Dashjax/RobocupSwinder/README.md

# RobocupSwinder
Robocup intro project with the goal to create a solenoid coil winder. :)
