Dashjax/RobocupSwinder/KiCad/BoardDeco/RoboBuzz wireframe.png

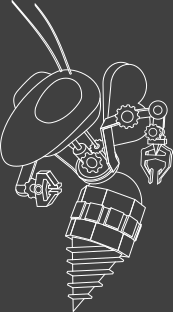
KiCad/BoardDeco/RoboBuzz wireframe.png
