Dashjax/RobocupSwinder/KiCad/final_report_bom.xlsx

Item | Links | Quantity | Price | Total
0.22uF Capacitor | https://www.digikey.com/en/products/detail/walsin-technology-corporation/1206B224K500CT/15980737 | 2 | 0.12 | 0.24
0.1uF Capacitor | https://www.digikey.com/en/products/detail/walsin-technology-corporation/1206B104K500CT/9355102 | 2 | 0.13 | 0.26
Barrel Jack | https://www.digikey.com/en/products/detail/same-sky-formerly-cui-devices/PJ-037A/1644545 | 2 | 0.6 | 1.2
10k Resistor | https://www.digikey.com/en/products/detail/yageo/RC1206FR-0710KL/728483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 | 4 | 0.1 | 0.4
1k Resistor | https://www.digikey.com/en/products/detail/yageo/RC1206FR-071KL/728387 | 4 | 0.1 | 0.4
2 Pin XH Connector Male | https://www.digikey.com/en/products/detail/jst-sales-america-inc/XHP-2/555485 | 2 | 0.1 | 0.2
2 Pin XH Connector Female | https://www.digikey.com/en/products/detail/jst-sales-america-inc/B2B-XH-A/1651045 | 2 | 0.1 | 0.2
8 Pin Header | https://www.digikey.com/en/products/detail/sullins-connector-solutions/PPTC081LFBN-RC/810147 | 8 | 0.56 | 4.48
24 Pin Header | https://www.digikey.com/en/products/detail/sullins-connector-solutions/PPTC241LFBN-RC/810162 | 4 | 1.3 | 5.2
Linear Regulator | https://www.digikey.com/en/products/detail/texas-instruments/LM340MPX-5-0-NOPB/367021 | 2 | 1.38 | 2.76
Limit Switches | https://www.amazon.com/HiLetgo-KW12-3-Roller-Switch-Normally/dp/B07X142VGC | 1 | 5.99 | 5.99
Power Switch | https://www.digikey.com/en/products/detail/e-switch/RA1113112R/3778055 | 2 | 0.71 | 1.42
I2C Adapter | https://www.amazon.com/HiLetgo-Interface-LCD1602-Address-Changeable/dp/B00VC2NEU8?gQT=0 | 1 | 7.49 | 7.49
LCD Screen | https://www.amazon.com/HiLetgo-Display-Backlight-Controller-Character/dp/B00HJ6AFW6 | 1 | 8.99 | 8.99
Screws | https://www.amazon.com/dp/B0B373RNJP/ref=twister_B0B373D6M8?_encoding=UTF8&th=1 | 1 | 4.5 | 4.5
Inserts | https://www.amazon.com/Mardatt-M2x4x3-5-Threaded-Printing-Embedment/dp/B08ZH89PK4 | 1 | 3.49 | 3.49
 |  |  |  | 47.22
