Dashjax/RobocupSwinder/KiCad/3dmodels/Same_Sky_PJ-037A.step

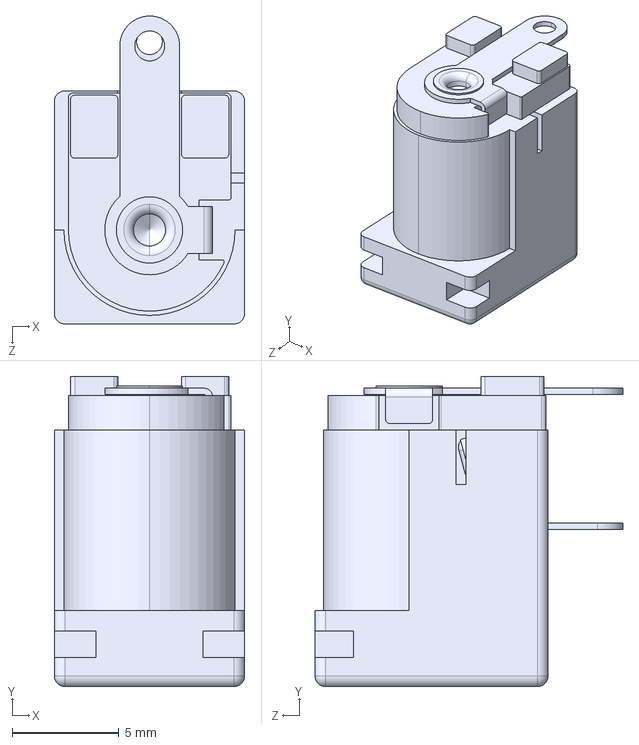
[picture p2: CAD file, 2025-03-05]
KiCad/3dmodels/Same_Sky_PJ-037A.step
8.90 x 14.5 x 14.4 mm
