Dashjax/RobocupSwinder/KiCad/RobocupSwinderPCB/RobocupSwinderPCB.kicad_pcb

## KiCad design KiCad/RobocupSwinderPCB/RobocupSwinderPCB.kicad_pcb (2025-10-14)

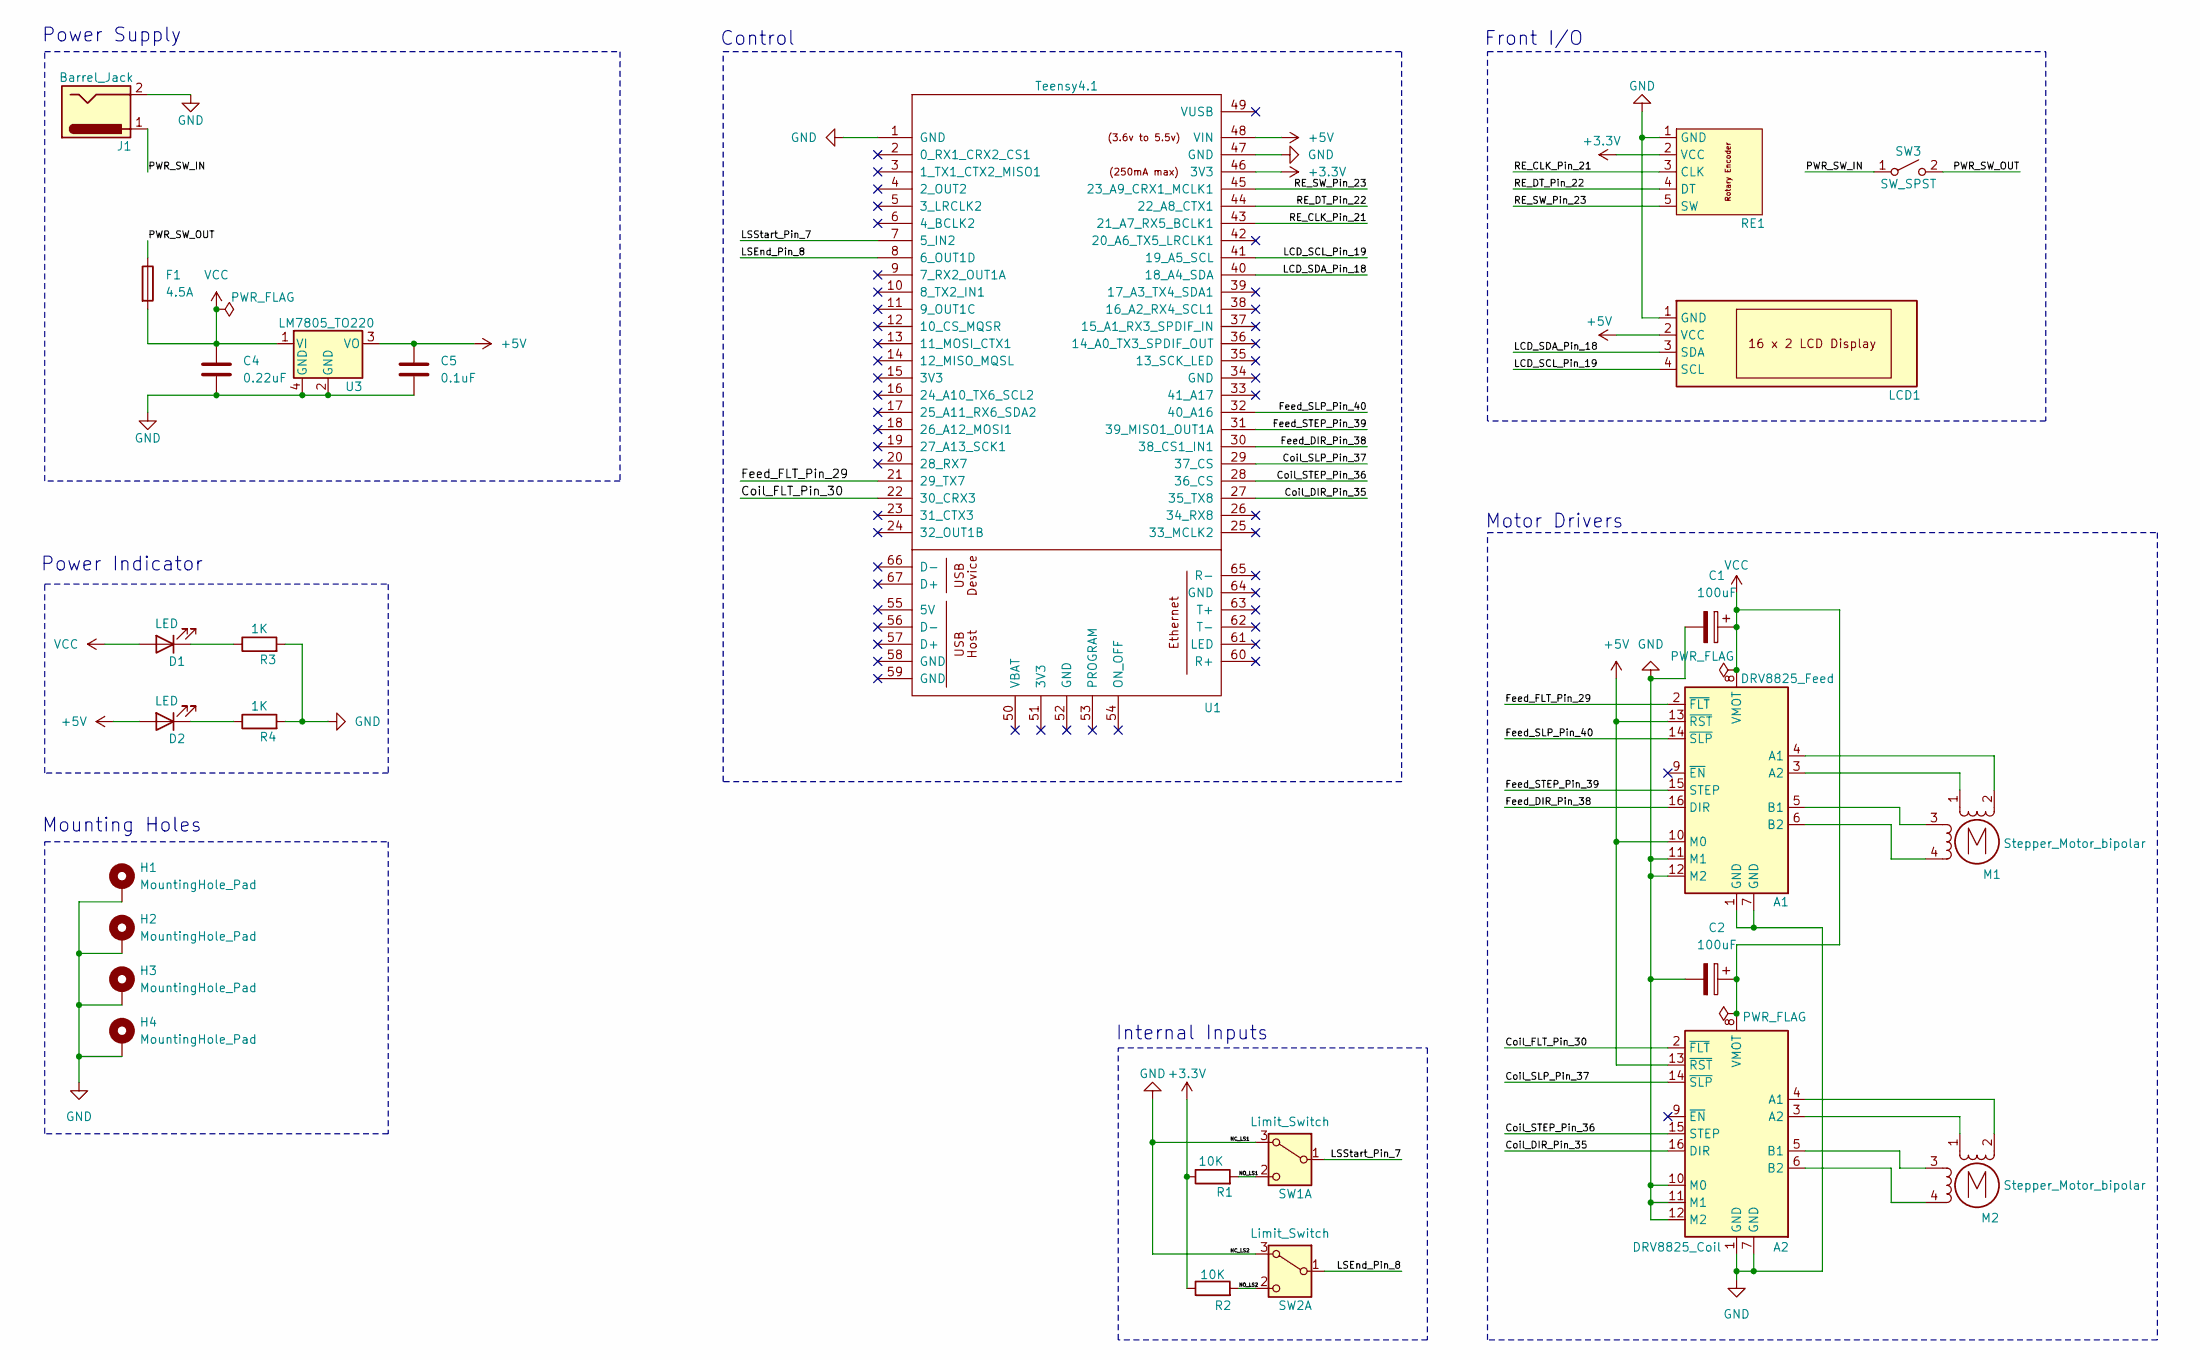
[picture p3: schematic RobocupSwinderPCB.kicad_sch, Robocup Swinder]

Parts:
A1: DRV8825_Feed; Pololu_Breakout-16_15.2x20.3mm
A2: DRV8825_Coil; Pololu_Breakout-16_15.2x20.3mm
C1, C2: 100uF; CP_Radial_D8.0mm_P3.50mm
C4: 0.22uF; C_1206_3216Metric_Pad1.33x1.80mm_HandSolder
C5: 0.1uF; C_1206_3216Metric_Pad1.33x1.80mm_HandSolder
D1, D2: LED; LED_0603_1608Metric_Pad1.05x0.95mm_HandSolder
F1: 4.5A; Fuse_1206_3216Metric
H1, H2, H3, H4: MountingHole_Pad; MountingHole_2.2mm_M2_DIN965_Pad
J1: Barrel_Jack; CUI_PJ-037A
LCD1: JST_XH_B4B-XH-A_1x04_P2.50mm_Vertical
M1, M2: Stepper_Motor_bipolar; JST_XH_B4B-XH-A_1x04_P2.50mm_Vertical
R1, R2: 10K; R_1206_3216Metric_Pad1.30x1.75mm_HandSolder
R3, R4: 1K; R_0603_1608Metric_Pad0.98x0.95mm_HandSolder
RE1: JST_XH_B5B-XH-A_1x05_P2.50mm_Vertical
SW1, SW2: Limit_Switch; JST_XH_B3B-XH-A_1x03_P2.50mm_Vertical
SW3: SW_SPST; JST_XH_B2B-XH-A_1x02_P2.50mm_Vertical
U1: Teensy4.1; Teensy41-Pins-Only_Silkscreen
U3: LM7805_TO220; SOT-223

Connections:
+3.3V: R1.1, R2.1, RE1.2 (VCC), U1.46 (3V3)
+5V: A1.10 (M0), A1.13 (~RST), A2.13 (~RST), C5.1, D2.2 (A), LCD1.2 (VCC), U1.48 (VIN), U3.3 (VO)
/Coil_DIR_Pin_35: A2.16 (DIR), U1.27 (35_TX8)
/Coil_FLT_Pin_30: A2.2 (~FLT), U1.22 (30_CRX3)
/Coil_SLP_Pin_37: A2.14 (~SLP), U1.29 (37_CS)
/Coil_STEP_Pin_36: A2.15 (STEP), U1.28 (36_CS)
/Feed_DIR_Pin_38: A1.16 (DIR), U1.30 (38_CS1_IN1)
/Feed_FLT_Pin_29: A1.2 (~FLT), U1.21 (29_TX7)
/Feed_SLP_Pin_40: A1.14 (~SLP), U1.32 (40_A16)
/Feed_STEP_Pin_39: A1.15 (STEP), U1.31 (39_MISO1_OUT1A)
/LCD_SCL_Pin_19: LCD1.4 (SCL), U1.41 (19_A5_SCL)
/LCD_SDA_Pin_18: LCD1.3 (SDA), U1.40 (18_A4_SDA)
/LSEnd_Pin_8: SW2.1 (C), U1.8 (6_OUT1D)
/LSStart_Pin_7: SW1.1 (C), U1.7 (5_IN2)
/NO_LS1: R1.2, SW1.2 (NO)
/NO_LS2: R2.2, SW2.2 (NO)
/PWR_SW_IN: J1.1, SW3.1 (A)
/PWR_SW_OUT: F1.1, SW3.2 (B)
/RE_CLK_Pin_21: RE1.3 (CLK), U1.43 (21_A7_RX5_BCLK1)
/RE_DT_Pin_22: RE1.4 (DT), U1.44 (22_A8_CTX1)
/RE_SW_Pin_23: RE1.5 (SW), U1.45 (23_A9_CRX1_MCLK1)
GND: A1.1 (GND), A1.7 (GND), A1.11 (M1), A1.12 (M2), A2.1 (GND), A2.7 (GND), A2.10 (M0), A2.11 (M1), A2.12 (M2), C1.2, C2.2, C4.2, C5.2, H1.1, H2.1, H3.1, H4.1, J1.2, LCD1.1 (GND), R3.2, R4.2, RE1.1 (GND), SW1.3 (NC), SW2.3 (NC), U1.1 (GND), U1.47 (GND), U3.2 (GND), U3.4 (GND)
unnamed: A1.4 (A1), M1.2 (-)
unnamed: A1.3 (A2), M1.1
unnamed: A1.5 (B1), M1.3
unnamed: A1.6 (B2), M1.4
unnamed: A2.4 (A1), M2.2 (-)
unnamed: A2.3 (A2), M2.1
unnamed: A2.5 (B1), M2.3
unnamed: A2.6 (B2), M2.4
unnamed: D1.1 (K), R3.1
unnamed: D2.1 (K), R4.1
VCC: A1.8 (VMOT), A2.8 (VMOT), C1.1, C2.1, C4.1, D1.2 (A), F1.2, U3.1 (VI)

Notes on the sheet:
Internal Inputs
Front I/O
Control
Power Supply
Motor Drivers
Mounting Holes
Power Indicator

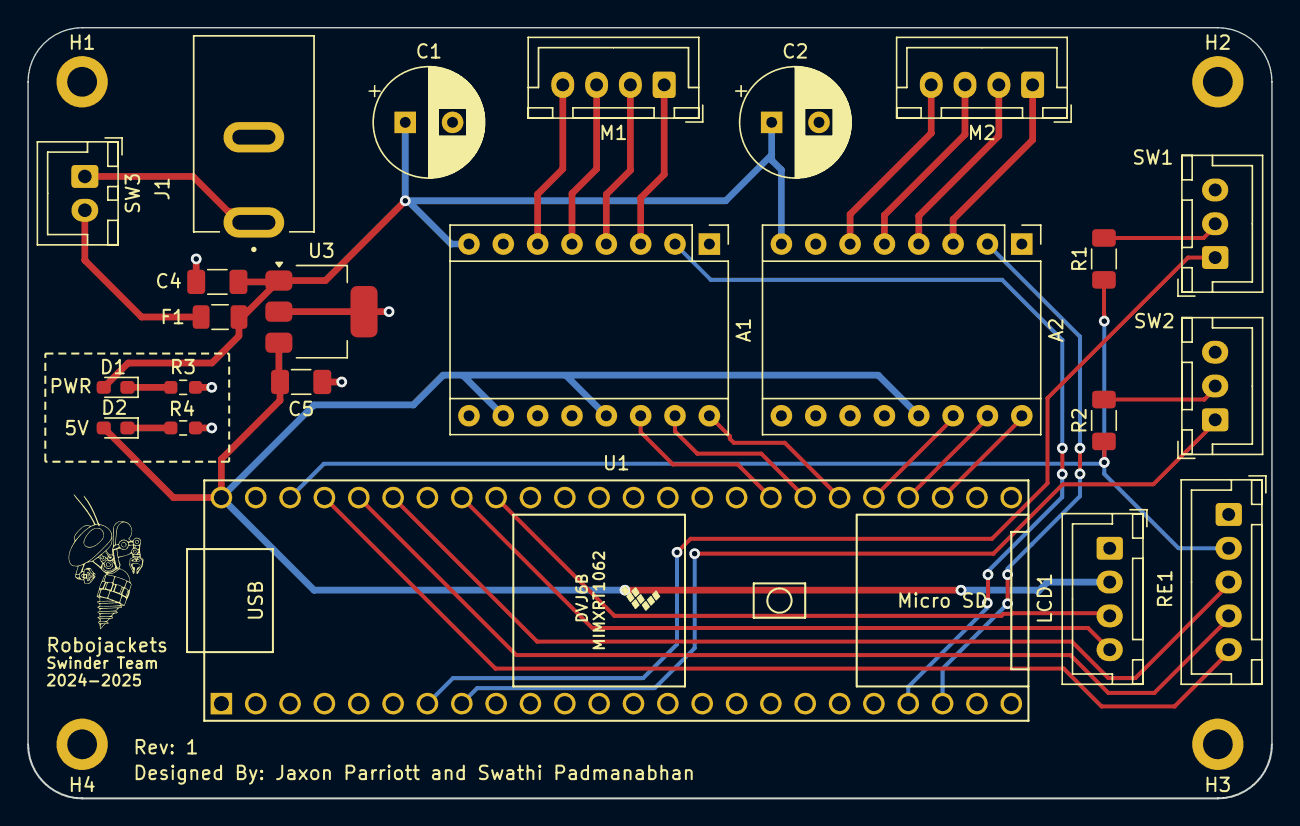
[picture p4: board RobocupSwinderPCB.kicad_pcb from above]

Board: 2 copper layers, 92.0 x 57.0 mm, 27 parts (0 on the bottom side), 33 nets.
