Dashjax/RobocupSwinder/Rust/swinder_v0.6/src/lib.rs

//!
//! Library of Constants and Definitions to make it
//! a bit easier to tweak the performance of the robots
//!

#![no_std]
#![feature(type_alias_impl_trait)]

extern crate alloc;

pub mod peripherals;
pub use peripherals::*;
