Dashjax/RobocupSwinder/(commit log)

2025-01-27 Replaced position based code in preset select with direction based.
    [swinder_v0.4.ino]
2025-01-27 Fixed screen clearing in val select
    [swinder_v0.4.ino]
2025-01-27 Added framework for val editor
2025-01-27 Added done button to val editor.
2025-01-27 Added button function to confirm screen.
2025-01-27 Added encoder function to confirm screen.
2025-01-27 Added stability delay to confirm screen.
    [swinder_v0.4.ino]
2025-01-27 Added stability delay to val select.
    [swinder_v0.4.ino]
2025-01-28 Fixed formatting and delay issues with button input.
    [swinder_v0.4.ino]
2025-01-28 Motor setup to spin.
2025-01-28 Switched to a percent rather than step counter to decrease delay in process loop.
2025-01-28 Switched from running all processes in the main loop to tying them directly to the previous function to allow entering at any point in the process.
2025-01-29 Added carriage initiation.
2025-01-29 A whole lotta stuff with motors.
2025-02-03 Added button press reading
2025-02-03 Removed cursor and added button delay to done.
2025-02-03 Initial KiCad commit.
    [RobocupSwinderPCB.kicad_pcb, RobocupSwinderPCB.kicad_sch]
2025-02-03 full teensy footprint
2025-02-03 Fixed footprint library.
2025-02-12 Transition to arduino v0.5.
2025-02-12 Switched carriage motor to half step.
2025-02-12 Added motor fault detection.
2025-02-19 Switched all encoder reads to interrupt based library.
2025-02-19 Switched to I2C port display.
2025-02-24 Added sleep control of motors.
2025-02-24 Outlined basics of schematic.
    [RobocupSwinderPCB.kicad_sch]
2025-02-26 Updated pin assignments.
    [RobocupSwinderPCB.kicad_pcb, RobocupSwinderPCB.kicad_sch]
2025-02-26 Updated pin assignments again.
2025-03-03 A whole lotta stuff.
    [RobocupSwinderPCB.kicad_pcb, RobocupSwinderPCB.kicad_sch]
2025-03-05 Added Teensy footprint with silkscreen
2025-03-05 Updated pcb layout.
    [PJ-037A.step, RobocupSwinderPCB.kicad_pcb, RobocupSwinderPCB.kicad_sch, Same_Sky_PJ-037A.step]
2025-03-05 Added buzz silkscreen.
    [RobocupSwinderPCB.kicad_pcb]
2025-03-10 Update and output files.
    [RobocupSwinderPCB-B_Cu.gbr, RobocupSwinderPCB-B_Mask.gbr, RobocupSwinderPCB-B_Paste.gbr, RobocupSwinderPCB-B_Silkscreen.gbr, RobocupSwinderPCB-Edge_Cuts.gbr, RobocupSwinderPCB-F_Cu.gbr, RobocupSwinderPCB-F_Mask.gbr, RobocupSwinderPCB-F_Paste.gbr]
2025-03-10 Update bom.csv
    added links
    [bom.csv]
2025-03-10 Delete KiCad/RobocupSwinderPCB/production/bom.csv
    bye bye bom
    [bom.csv]
2025-03-11 Pcb cleanup
    [RobocupSwinderPCB.kicad_pcb, RobocupSwinderPCB.kicad_sch]
2025-03-12 More pcb cleanup.
    [RobocupSwinderPCB.kicad_pcb, RobocupSwinderPCB.kicad_sch]
2025-03-12 Removed filter inductor and cap.
    [RobocupSwinderPCB.kicad_pcb, RobocupSwinderPCB.kicad_sch]
2025-03-12 updated pin assignments in arduino code.
2025-03-25 fixed pin name.
    [RobocupSwinderPCB.kicad_pcb, RobocupSwinderPCB.kicad_sch]
2025-03-26 Redo bom.
    [bom.csv, designators.csv, final_bom.csv, old_bom.csv, positions.csv]
2025-03-26 Lotta stuff.
    [RobocupSwinderPCB-B_Cu.gbr, RobocupSwinderPCB-B_Mask.gbr, RobocupSwinderPCB-B_Paste.gbr, RobocupSwinderPCB-B_Silkscreen.gbr, RobocupSwinderPCB-Edge_Cuts.gbr, RobocupSwinderPCB-F_Cu.gbr, RobocupSwinderPCB-F_Mask.gbr, RobocupSwinderPCB-F_Paste.gbr]
2025-03-27 Fixed bom
    [final_report_bom.xlsx]
2025-10-14 Final commit till v1.0
    [RobocupSwinderPCB.kicad_pcb, RobocupSwinderPCB.kicad_sch]
2025-10-17 Started framwork of library to hold all solenoid values and math.
2025-10-17 Added wire gauges to enum.
2025-10-17 Started string formatting functions for Solenoid.
2025-10-17 Switch string formatting over to solenoid lib
2025-10-17 Switched task to enum format.
2025-10-17 Added wire gauge setters/getters
2025-10-17 Started phasing out old solenoid implimentation
2025-10-20 Moved string formatting out of Solenoid lib to simplify and avoid overreach
    [main.cpp]
2025-10-20 Added motor fault functionality.
2025-10-22 Near final stage.
2025-10-26 Switched return after end to valselect for easier re-run
2025-10-26 Remove old KiCad files.
    [PJ-037A.step, old_bom.csv, old_final_bom.csv]
